BrutalistInstruments/Tsunami-CS-1/Enclosure/enclosureReadMe.md

## Enclosure
Current revision of enclosure has a few issues, but will be resolved with final revision of Front Panel and IO PCBs. Issues will be solved when final revision is complete.
