BrutalistInstruments/Tsunami-CS-1/Schematic/TsunamiCS-1Rev9.pdf

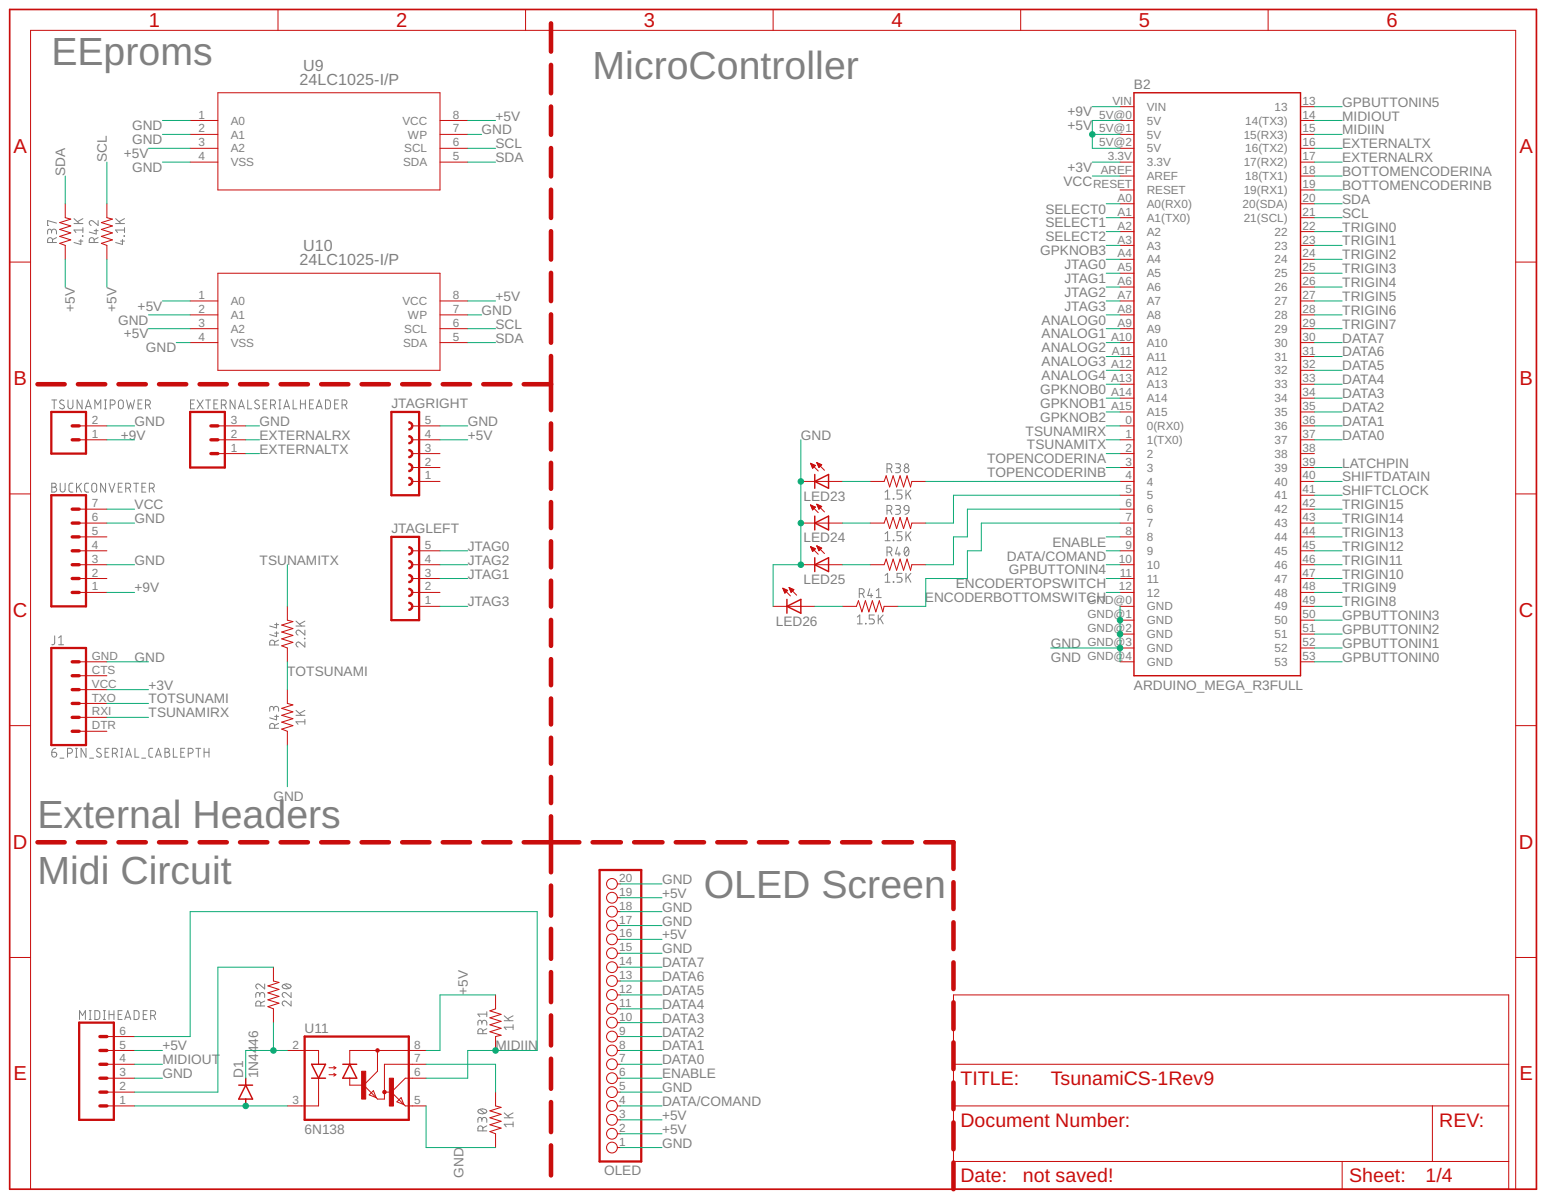
[picture p1: page 1]

Document Number: | REV:

Date: not saved! | Sheet: 1/4

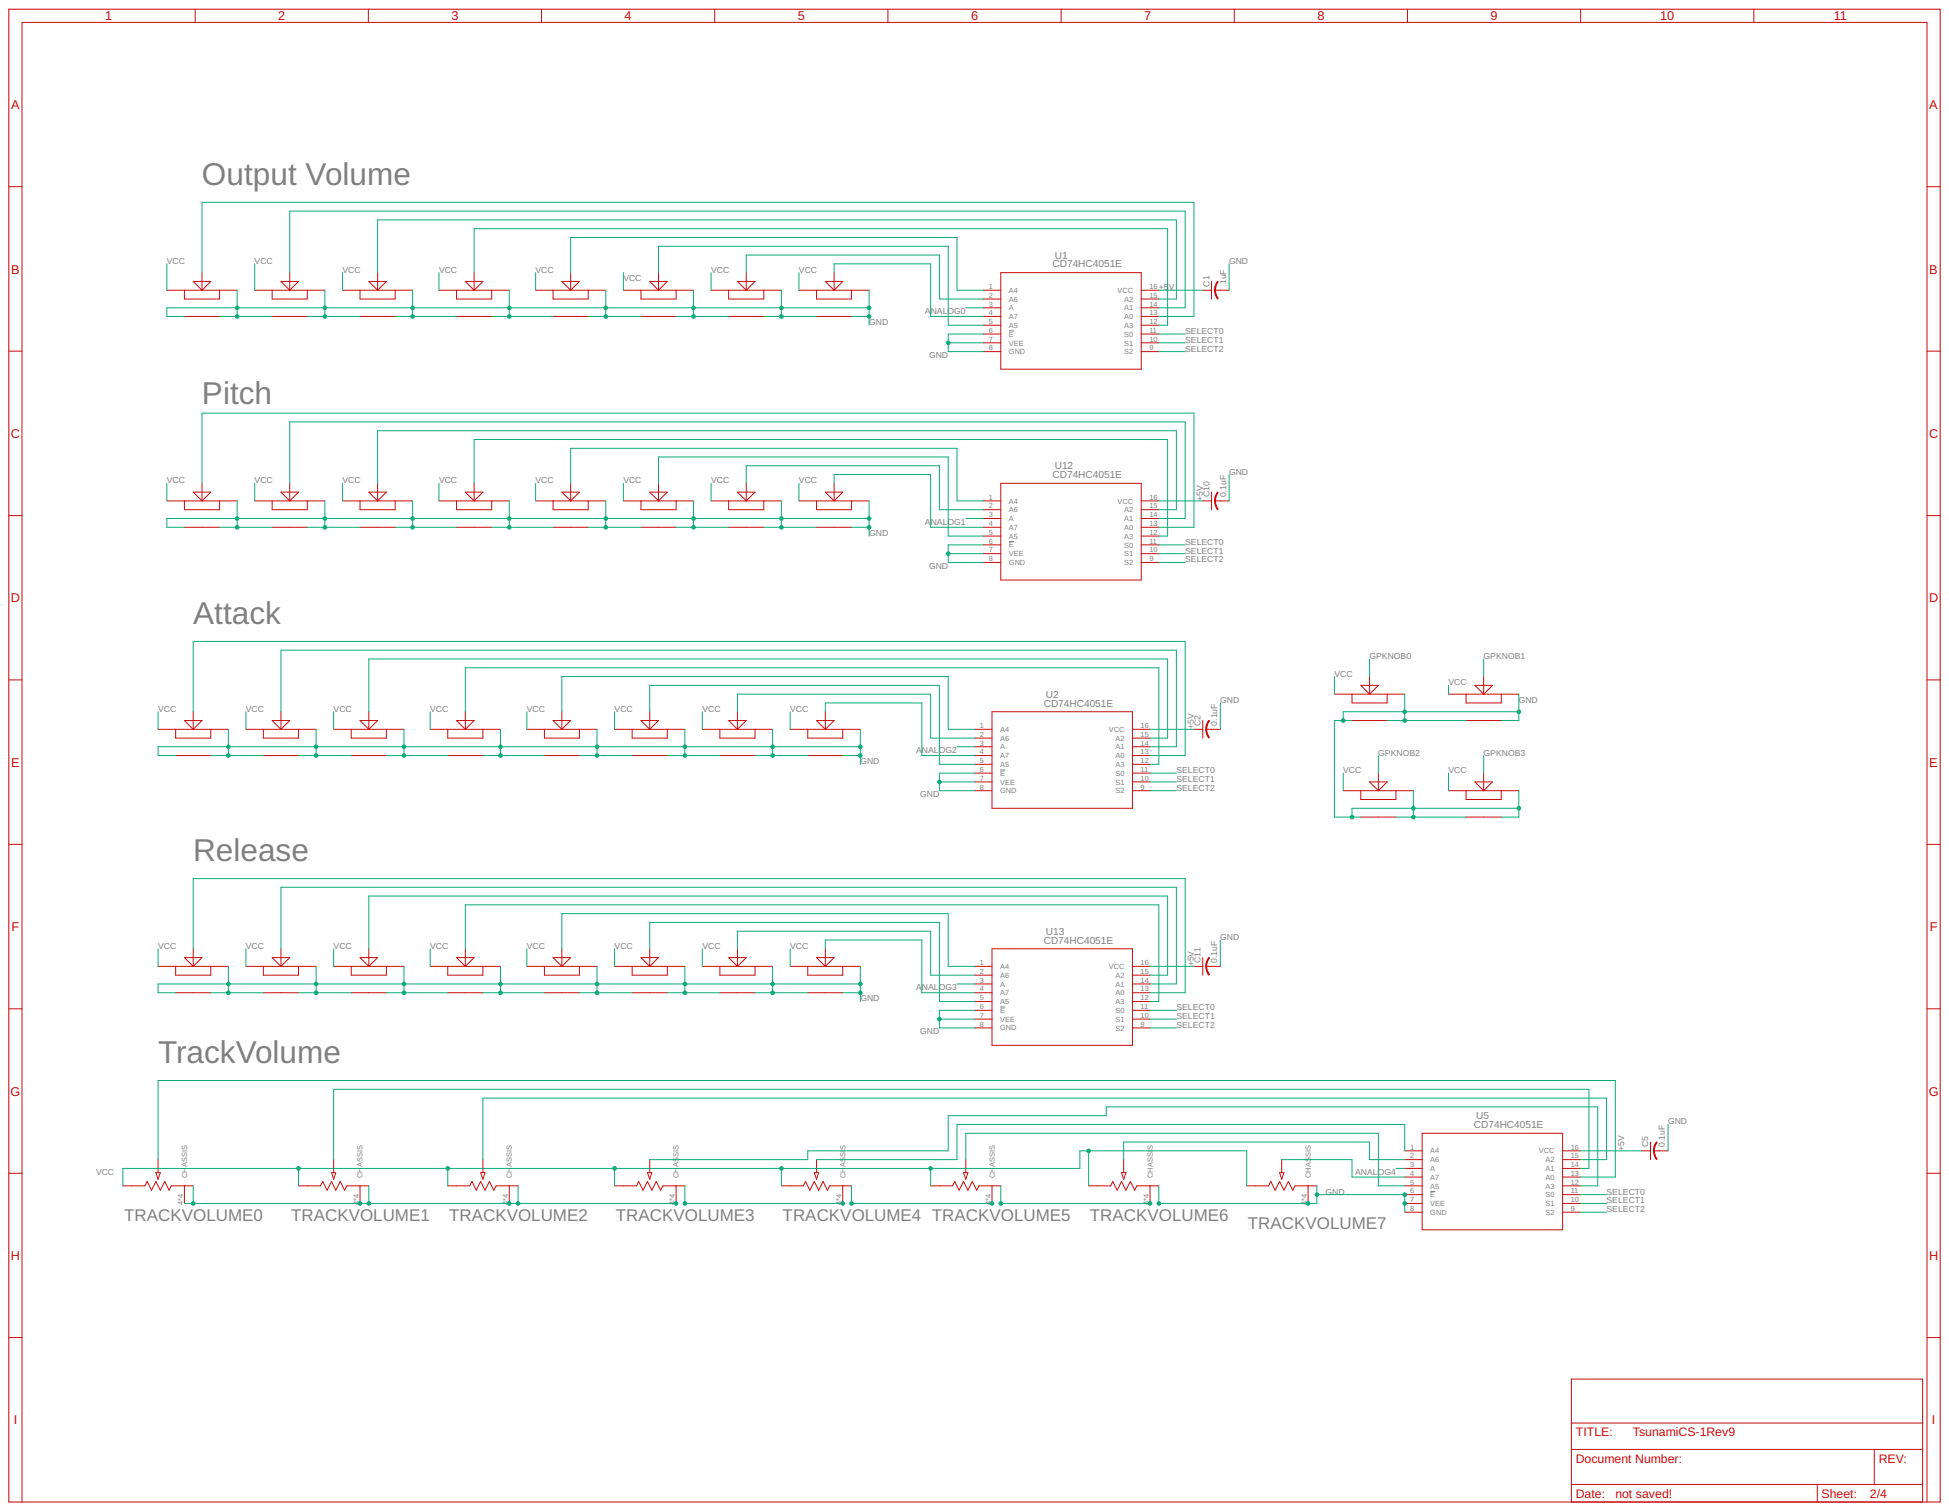
[picture p2: page 2]

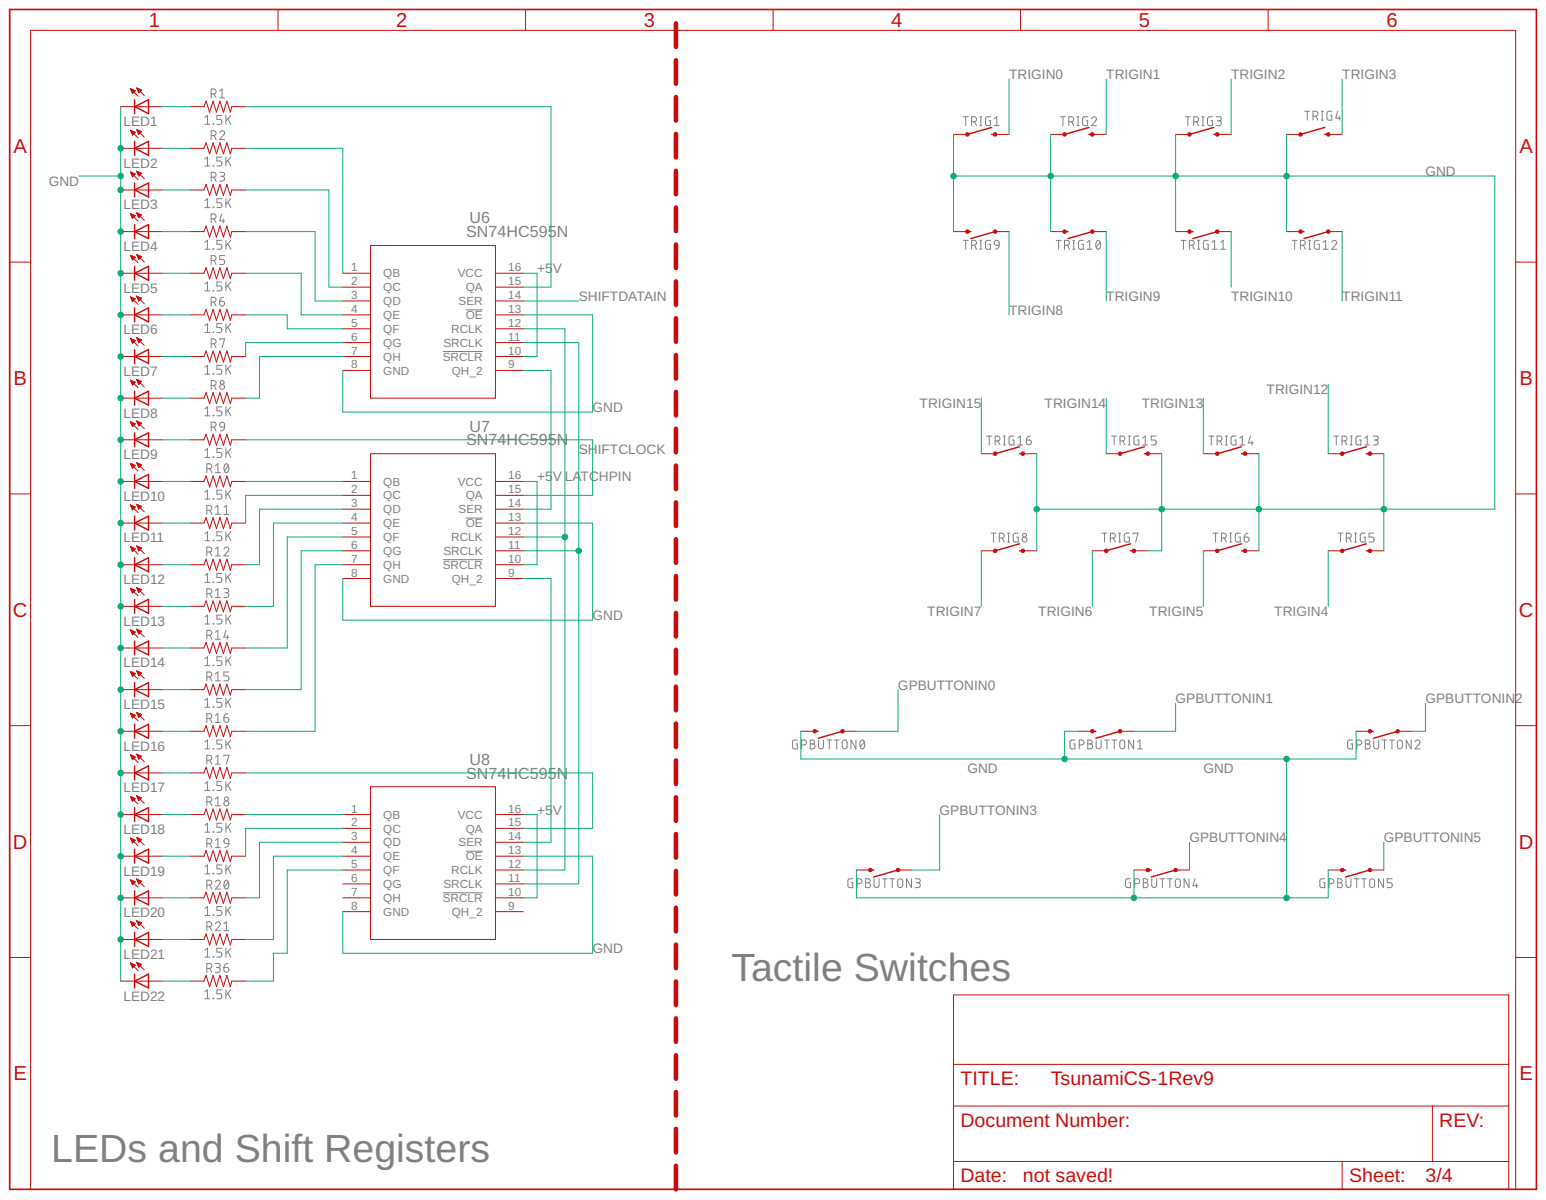
[picture p3: page 3]

LEDs and Shift Registers

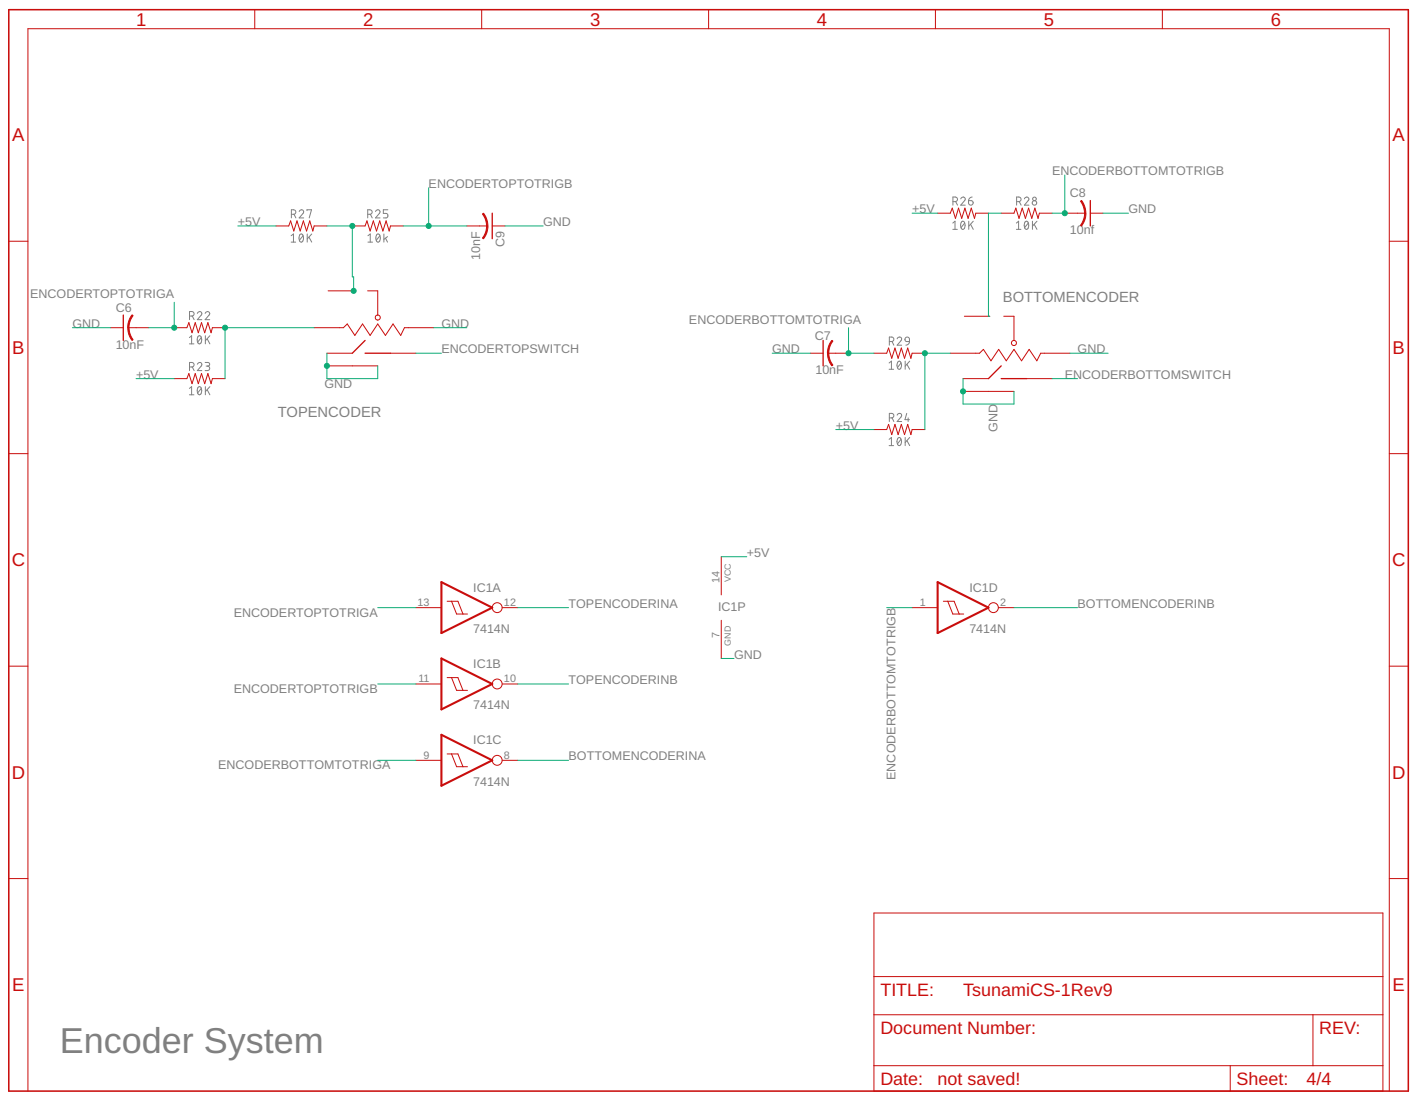
[picture p4: page 4]
