BrutalistInstruments/Tsunami-CS-1/TsunamiCS1Master/sequencerLib.h

#ifndef SEQUENCERLIB_H_
#define SEQUENCERLIB_H_

#include "globalVariables.h"

void initSequencer();
void updateSequencer(Pattern sequencerPattern, Globals *currentGlobals);

#endif /* SEQUENCERLIB_H_ */
