BrutalistInstruments/Tsunami-CS-1/TsunamiCS1Master/menu.h

/*
 * menu.h
 *
 * Created: 8/13/2019 5:54:40 PM
 *  Author: Hal
 */


#ifndef MENU_H_
#define MENU_H_

void initMenu(Screen *initTheScreen, Pattern currentPattern, Globals currentGlobals);
void updateScreen(Screen *menuScreen, Pattern *currentPattern, Globals *currentGlobals);
//void numToMidiNote(uint8_t inputNum, char midiNote[3]);



#endif /* MENU_H_ */
