BrutalistInstruments/Tsunami-CS-1/(commit log)

2019-08-20 Added knob read functionallity for output Volume and Track Volume
2019-08-21 Reading all knobs, fully functional OutVolume, Pitch, and Track Volume knobs
2019-08-21 Changed Knob filter from FIR to IIR
2019-08-22 Added LED functionallity to trigger buttons
2019-08-24 Added sample assignment, begining of robust menu
2019-08-30 Added Cursor to menus, and reading encoder buttons
2019-08-30 Added push button Encoder Functionallity to Global Menu
2019-09-03 Changed Encoder A from polling to interupt, seems to be more stable
2019-09-05 All menus currently functional
2019-09-07 added encoder switch debouncing, needs some timing work on interupts
2019-09-10 encoder buttons sucessfully debounced
2019-09-15 Added arduino core for arduino upload
2019-09-15 Working on getting the arduino uploader ready
2019-10-27 Added schematic, and new version of Arduino Core
2020-02-06 updated arduino core codebase, lots of bug fixes
    [ButtonLib.h, EncoderLib.h, LEDLib.h, MidiLib.h, globalVariables.h, knobLib.h, main.c, sequencerLib.h]
2020-06-23 Fixed knob read errors when bank switch is active
    [menu.c]
2020-06-24 fixed envelope menu issues, added new pattern members to eeprom save and load
    [EncoderLib.c, globalVariables.c, globalVariables.h, menu.c, twiLib.c]
2020-06-24 EEprom fix, and plans for envelopes laid out for tommorrow
    [tsunamiLib.c, tsunamiLib.h, twiLib.c]
2020-06-24 timer interupt added for envelopes, play Track functionallity complete
2020-06-25 Correct printing for release and sustain stages
    [EncoderLib.c, knobLib.c, menu.c, tsunamiLib.c]
2020-06-26 Fixed bug where Track settings displays garbage
    [main.c, menu.c, sequencerLib.c, tsunamiLib.c]
2020-06-26 bug fix for sequencer pages not persisting over menu changes
    [ButtonLib.c, EncoderLib.c]
2020-06-28 Factory Reset skeleton laid out, encoders acting slightly more resposiveley
    [EncoderLib.c, main.c]
2020-07-01 Volume printing in positive DB ranges fixed
    [menu.c]
2020-07-01 attack and release times now clamped to 20ms minimums
2020-07-06 Cleaned up factory reset, untested
    [globalVariables.c, globalVariables.h, knobLib.c, main.c]
2020-07-07 fixed bug where sequencer does not use envelopes
    [sequencerLib.c]
2020-08-02 updated readme and added BOM
2020-08-02 made note about audio connectors
2020-08-02 updated bom with suitable replacement for audio jacks
2020-08-08 testing out some new encoder code, updated BOM
2020-08-08 updated BOM with physical part numbers
2020-08-08 rollback on first encoder experiment
2020-08-17 updated markdown in BOM, looks nicer now
2020-08-17 fixed a few typos in BOM
2020-08-19 New schematic Files added. Looking a lot nicer
2020-08-22 added .hex file to Arduino Core
2020-08-22 added readme to Arduino folder, updated main readme
2020-09-03 Schematic File is now much more readable / printable
